thillRobot/mcu-rocket/launch-data/linearacceleration_06_24_2021.png

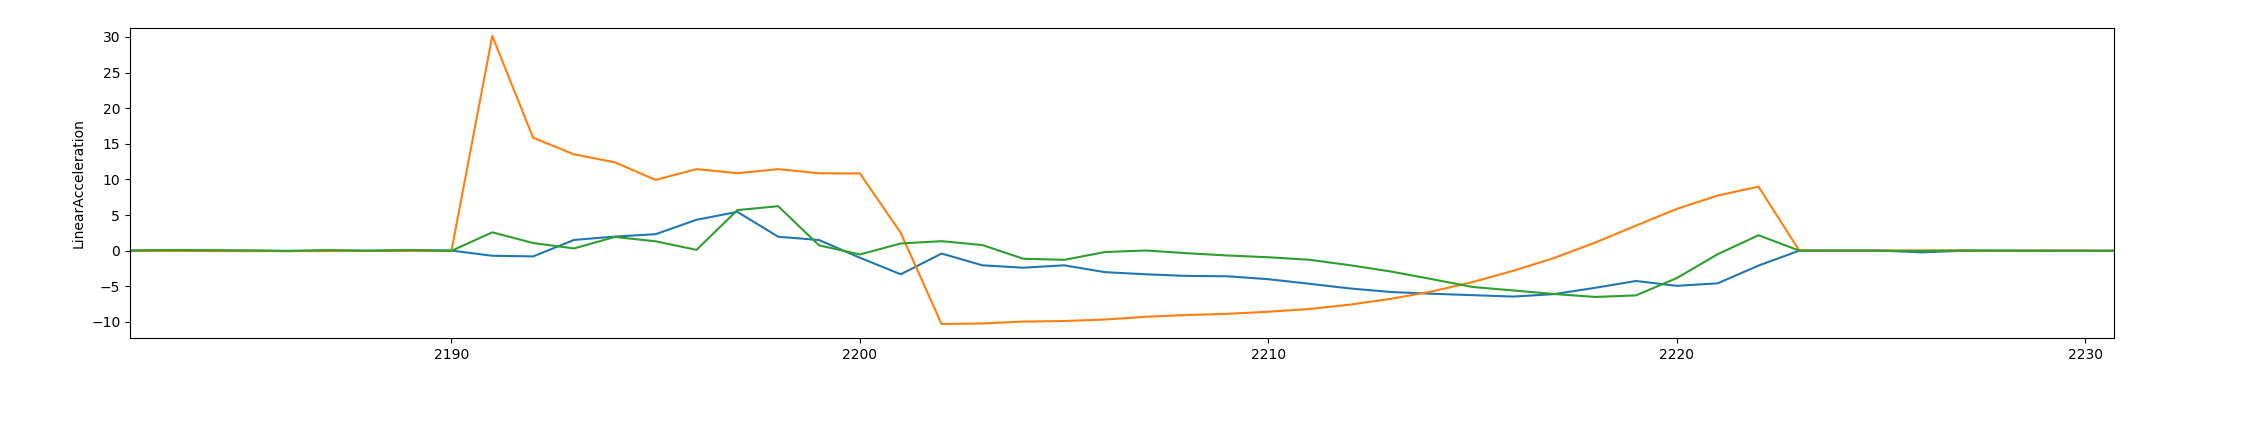
launch-data/linearacceleration_06_24_2021.png
