thillRobot/mcu-rocket/launch-data/NANO-0-06-25-2025-zoomed.png

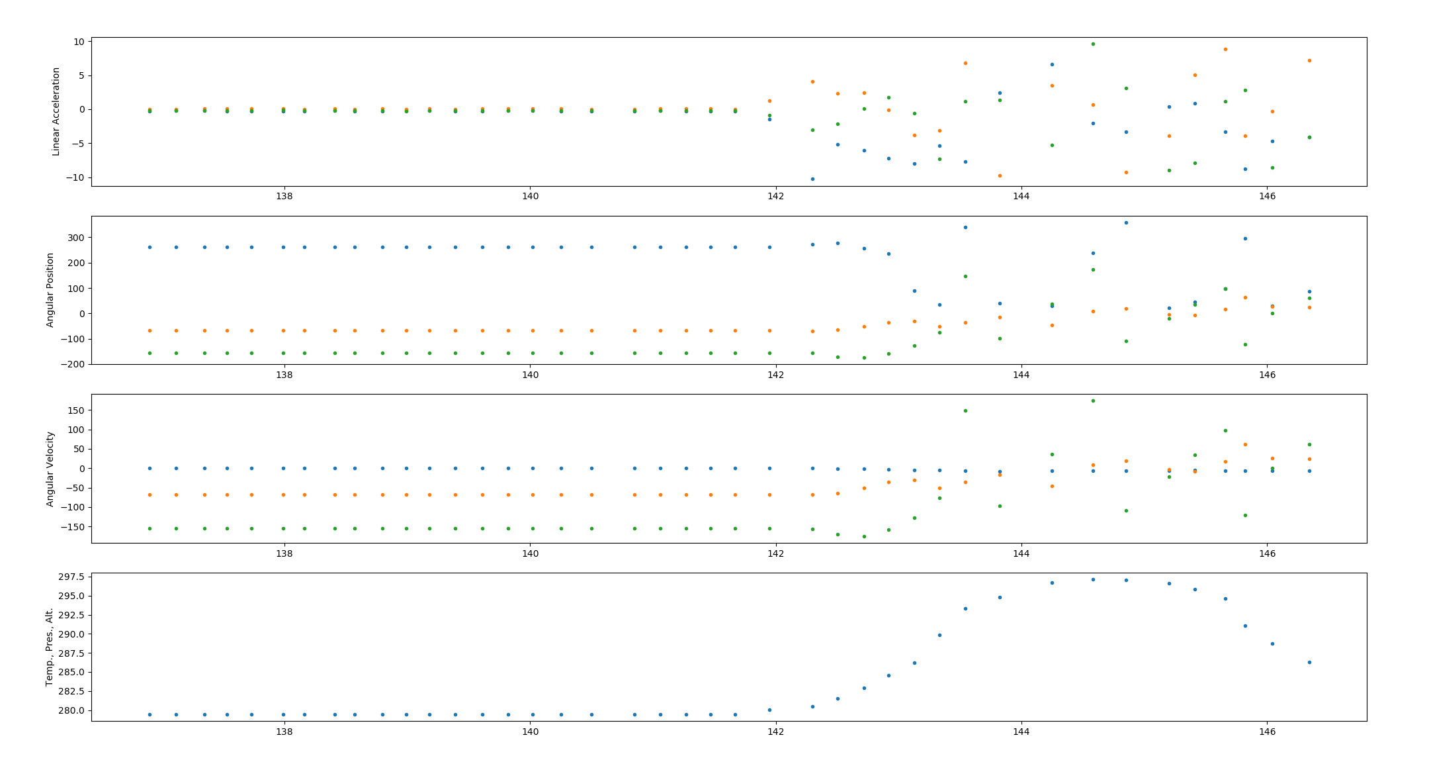
launch-data/NANO-0-06-25-2025-zoomed.png
