thillRobot/mcu-rocket/launch-data/NANO-0-06-25-2025.png

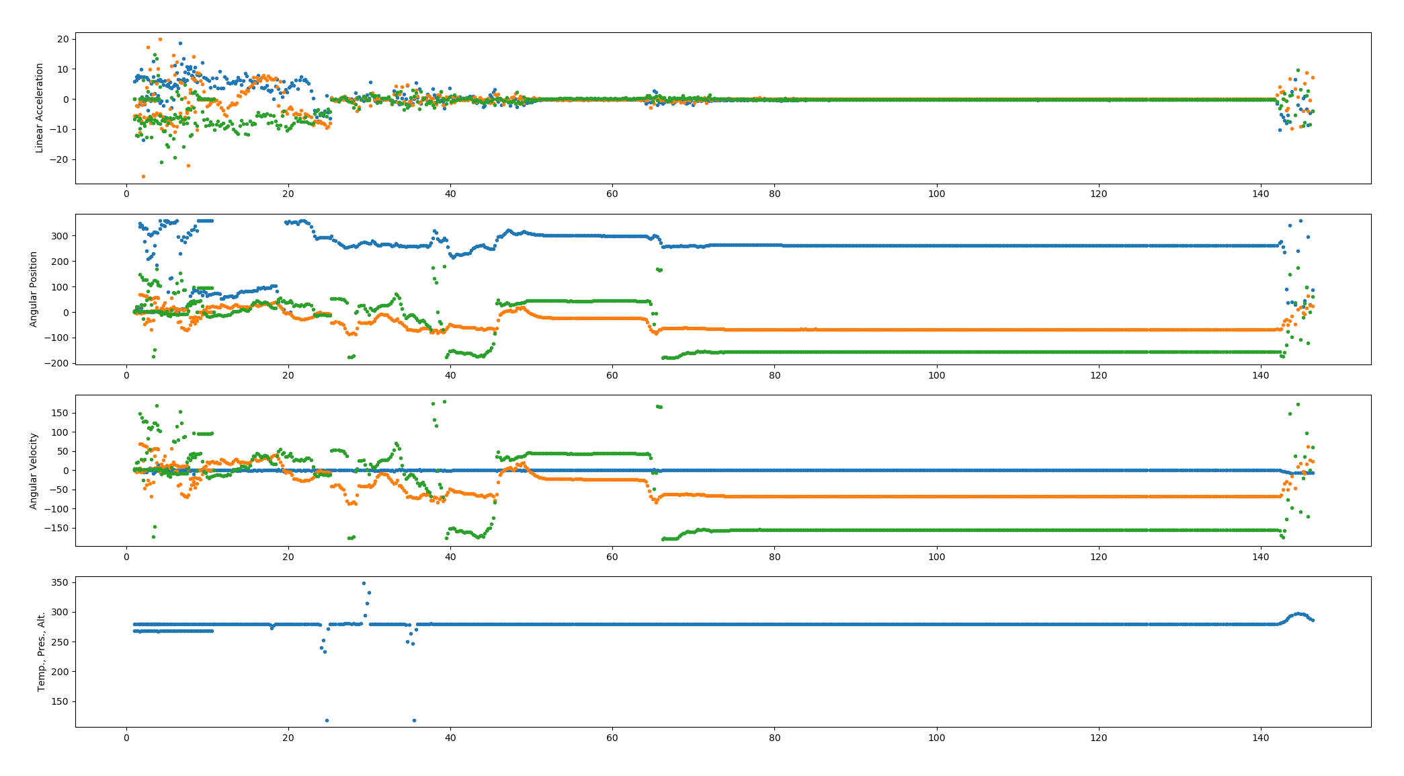
launch-data/NANO-0-06-25-2025.png
