thillRobot/mcu-rocket/launch-data/NANO-1-06-24-2021.png

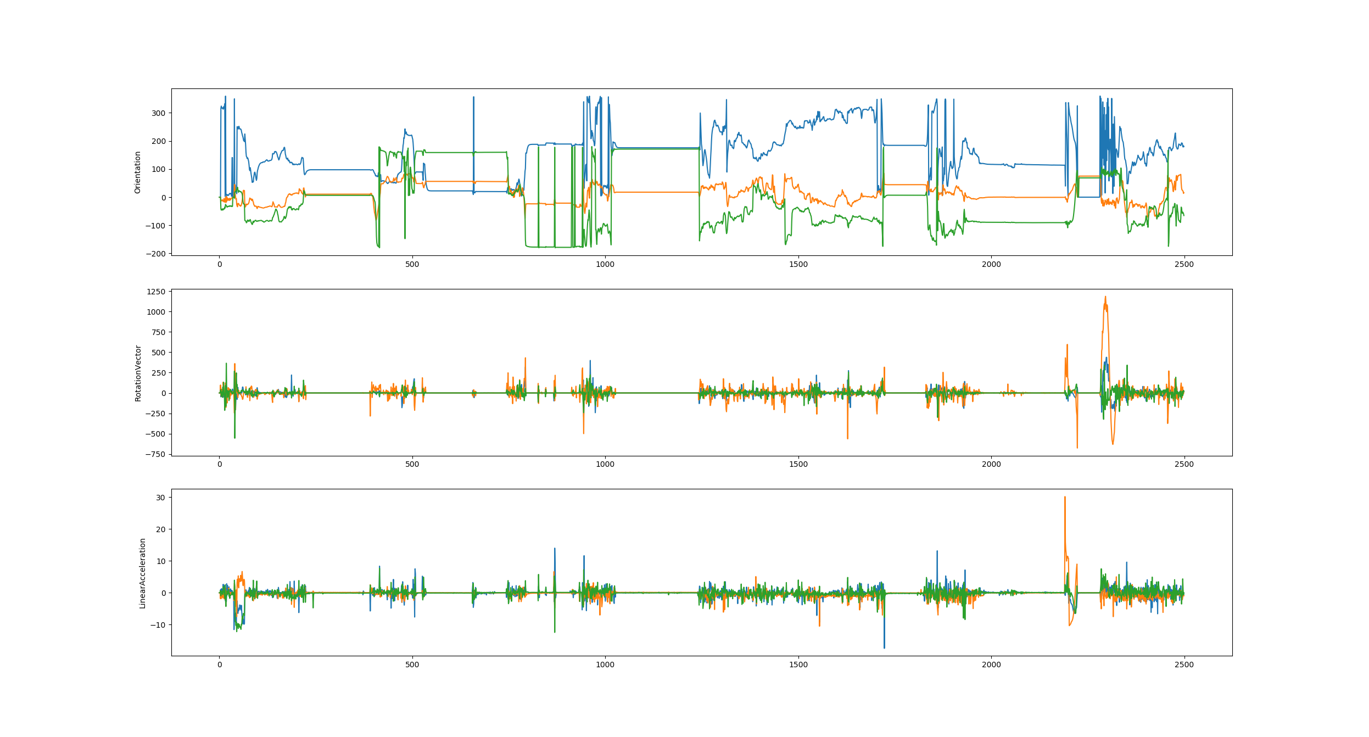
launch-data/NANO-1-06-24-2021.png
