thillRobot/mcu-rocket/launch-data/NANO-1-06-24-2021_cropped_0_250.png

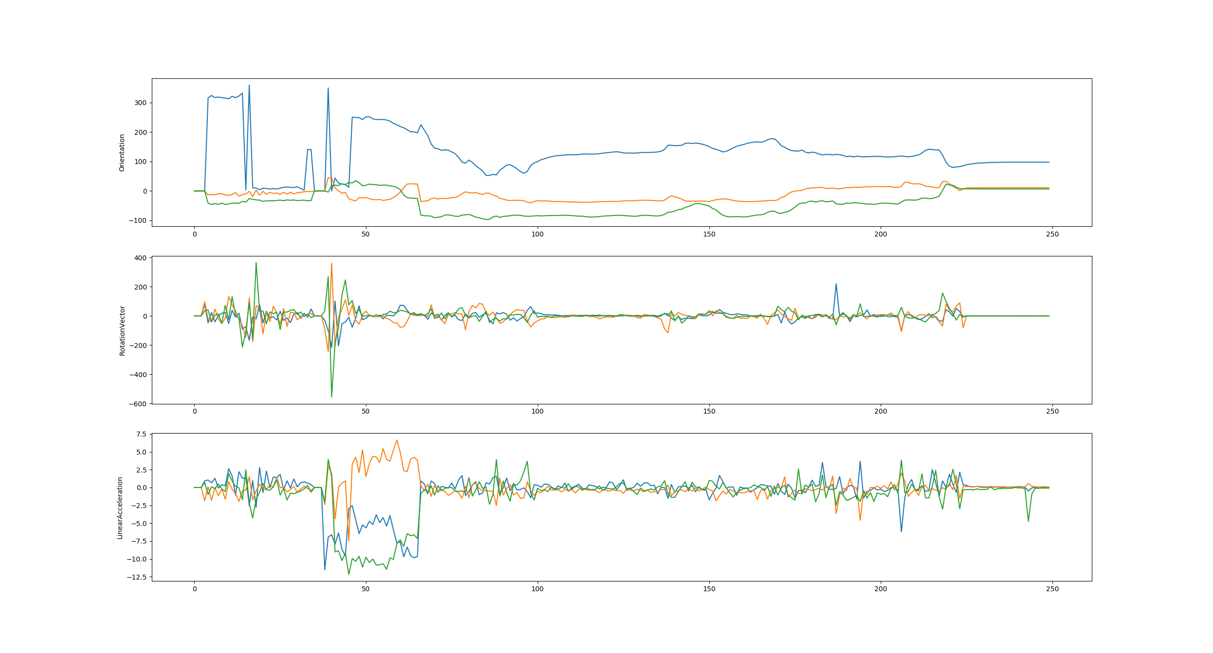
launch-data/NANO-1-06-24-2021_cropped_0_250.png
