thillRobot/mcu-rocket/launch-data/NANO-1-06-24-2021_cropped_2150_2450.png

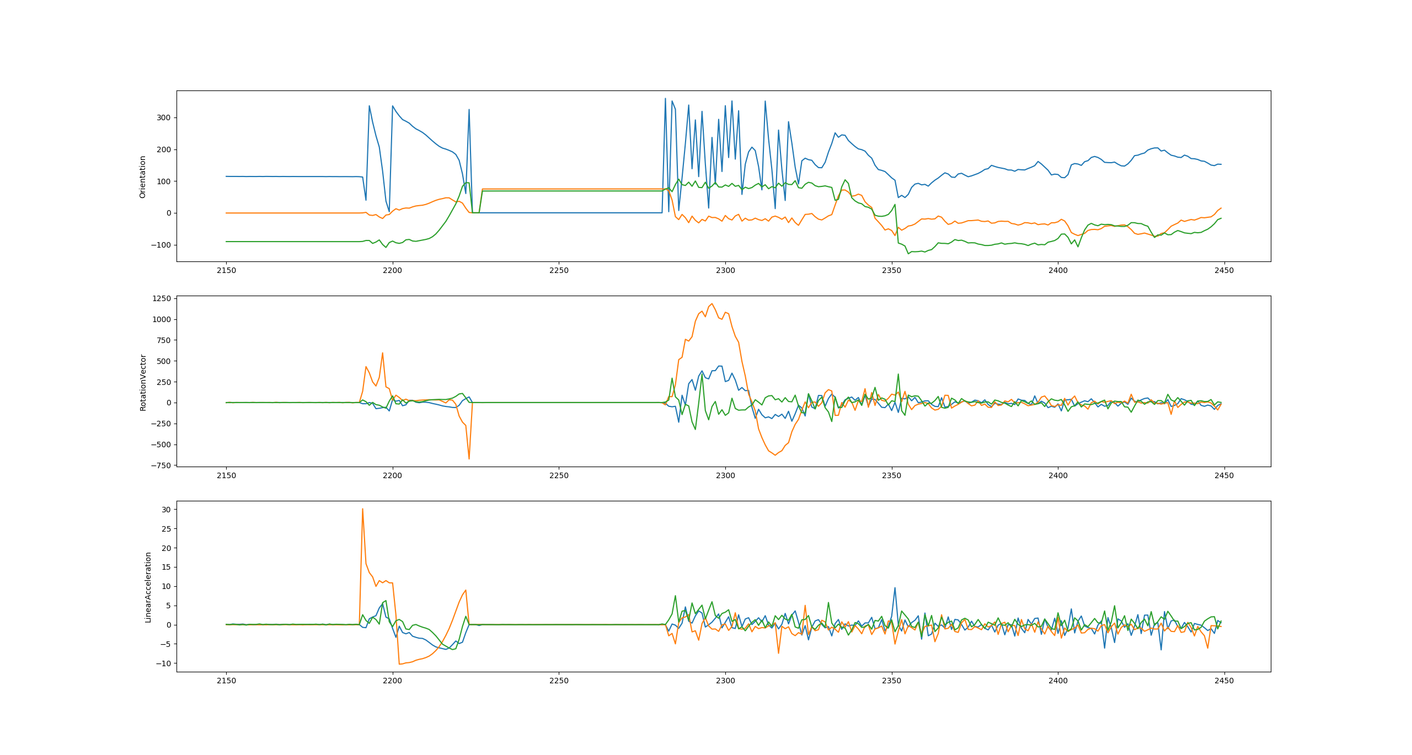
launch-data/NANO-1-06-24-2021_cropped_2150_2450.png
