thillRobot/mcu-rocket/launch-data/NANO-300-06-25-2025.png

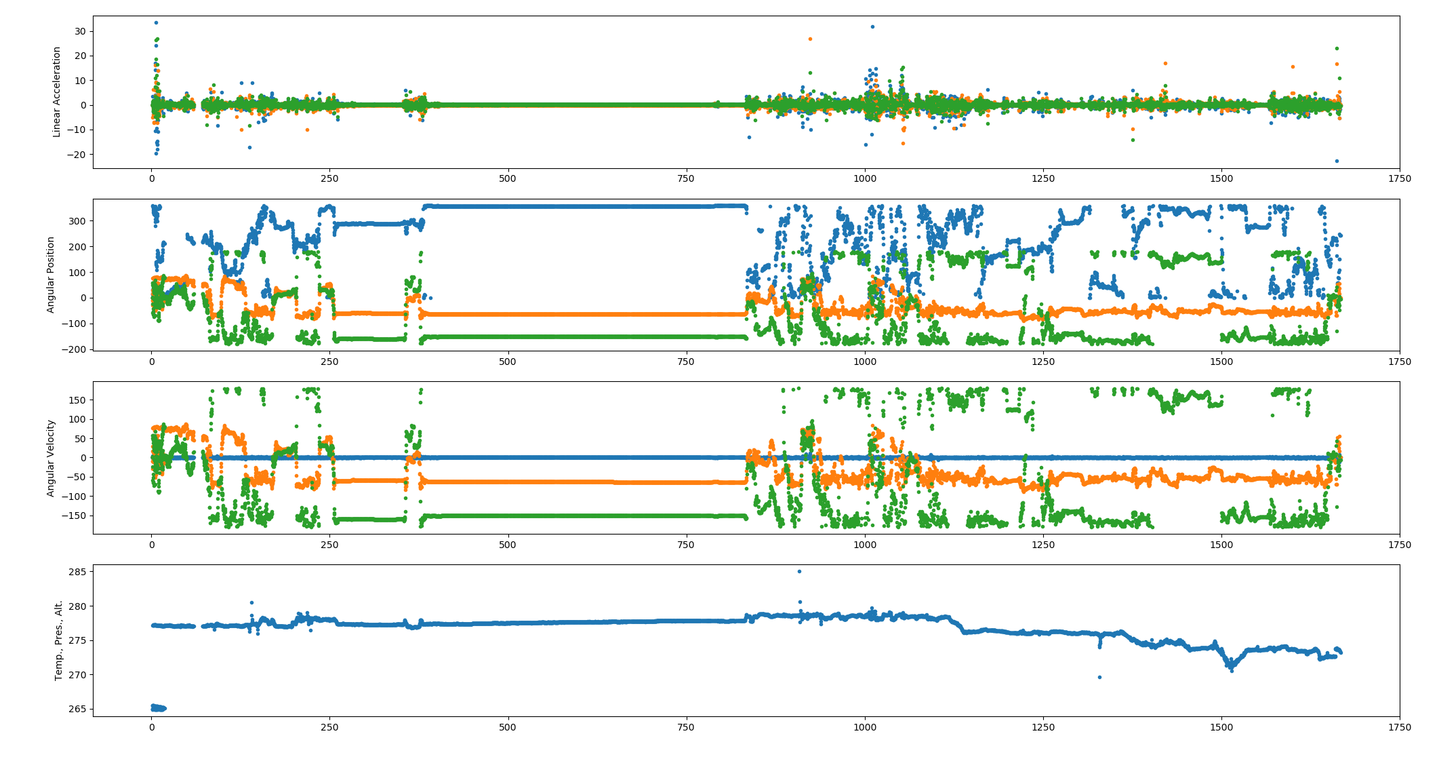
launch-data/NANO-300-06-25-2025.png
