thillRobot/mcu-rocket/pcb-design/kicad/mcu_rocket_nano/mcu_rocket_nano_top.png

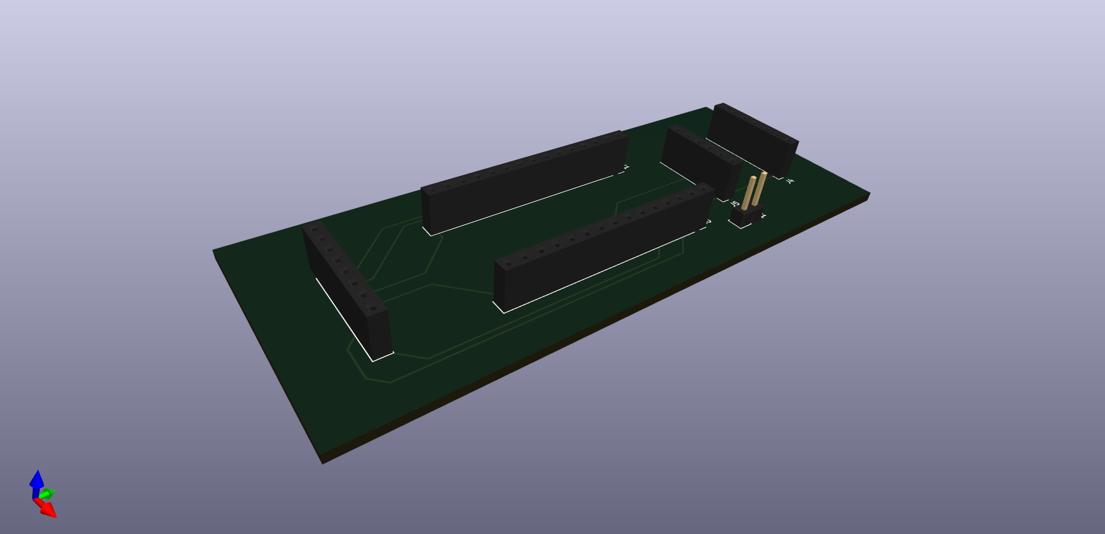
pcb-design/kicad/mcu_rocket_nano/mcu_rocket_nano_top.png
