thillRobot/mcu-rocket/rocket-design/png-images/motor_mount1.png

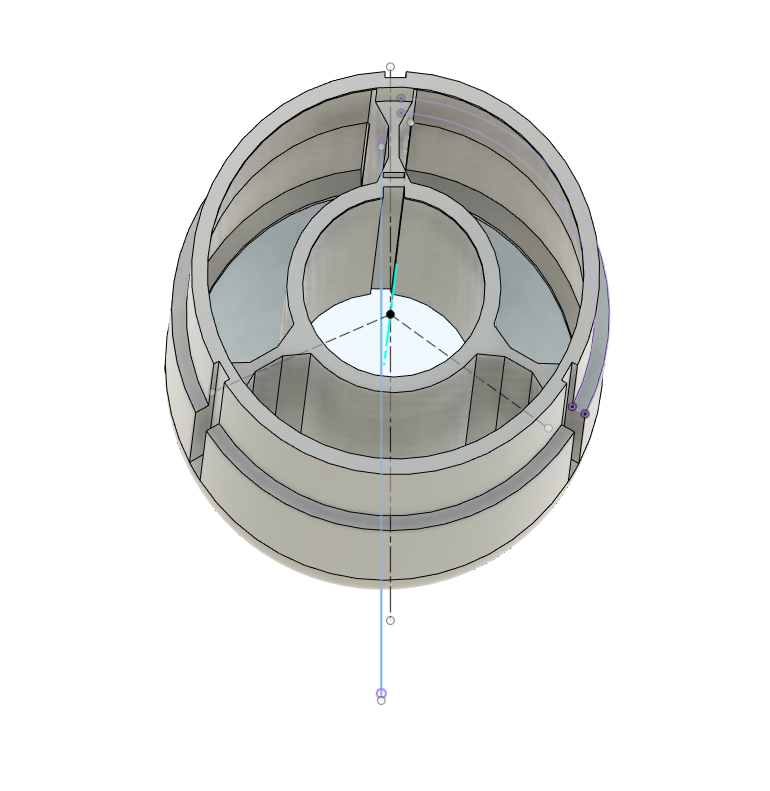
rocket-design/png-images/motor_mount1.png
