thillRobot/mcu-rocket/rocket-design/png-images/science_nosecone2.png

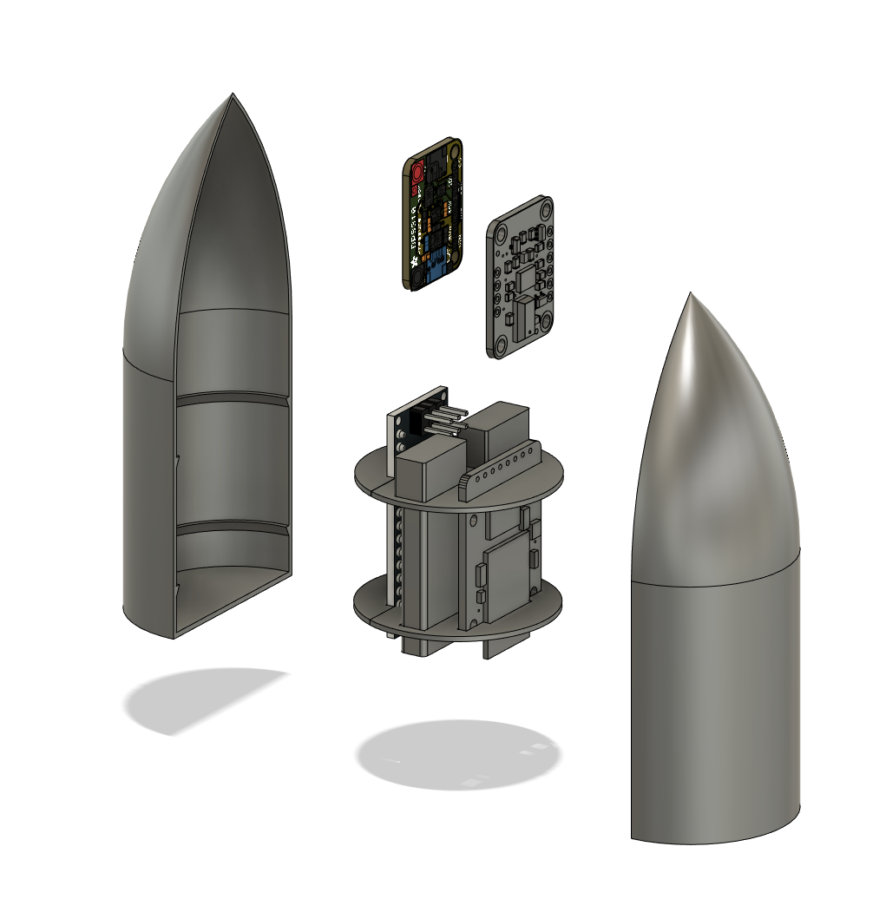
rocket-design/png-images/science_nosecone2.png
