thillRobot/mcu-rocket/rocket-design/png-images/science_nosecone5.png

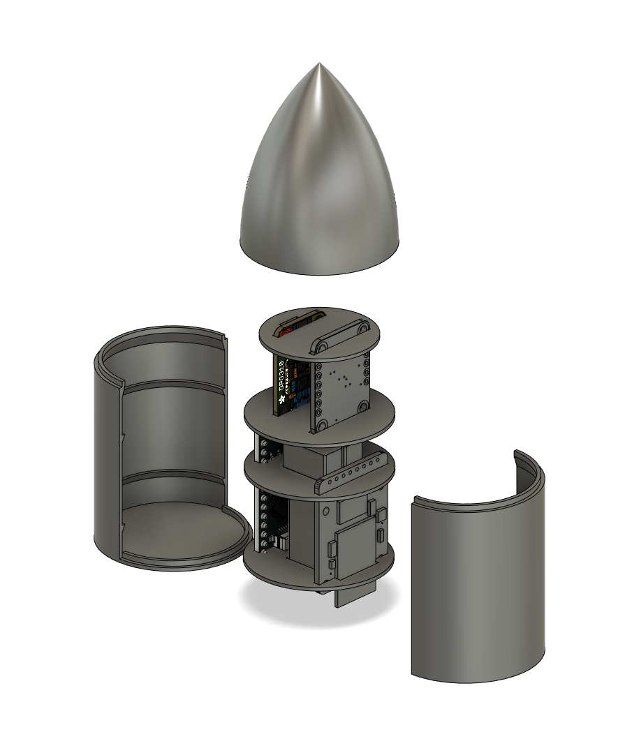
rocket-design/png-images/science_nosecone5.png
