thillRobot/mcu-rocket/rocket-design/png-images/science_nosecone.png

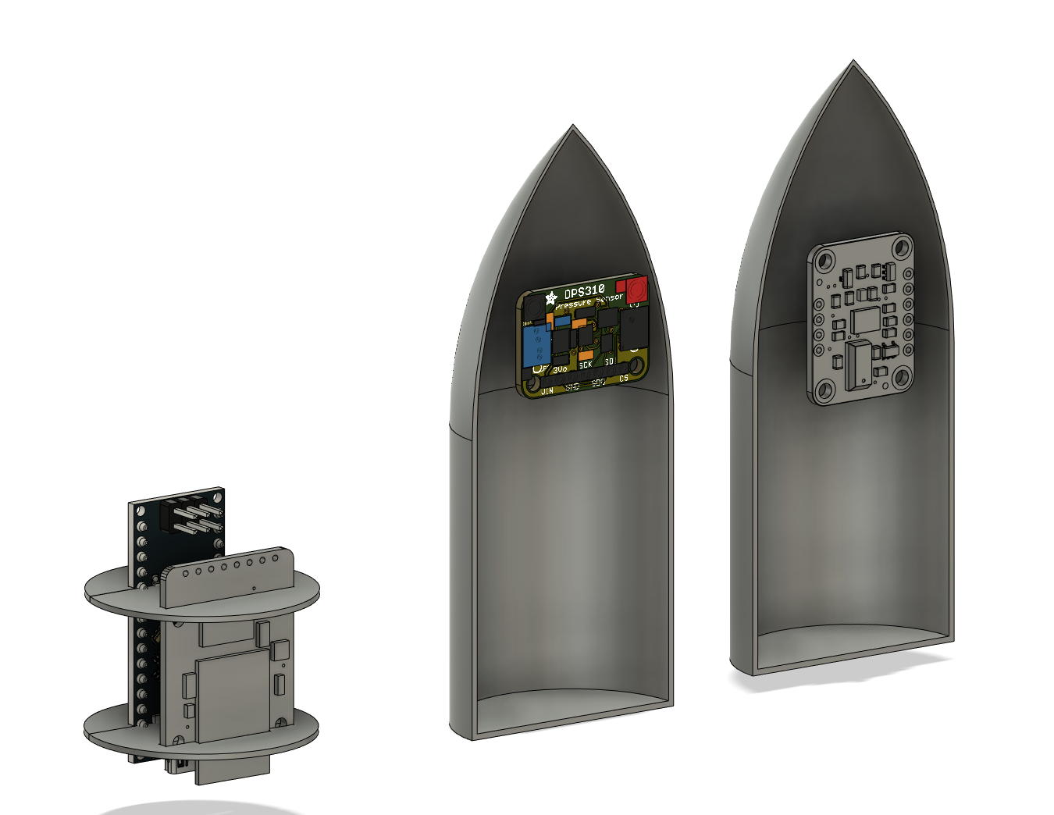
rocket-design/png-images/science_nosecone.png
