thillRobot/mcu-rocket/rocket-design/rocket_design_tables.xlsx

GSET - Summer 2021 - Rocket Design - Tristan Hill
This excel table is used for choosing parameters for the design for a custom model rocket with on-board sensing.
 | Design Variables |  |  |  |  | Material Properties |  |  |  |  | Design Equations
 | Name | Symbol | Unit | Values | Source | Name | Symbol | Unit | Values | Source | Name | Equation
 | distance_nose | dn | mm |  |  | density_petg | rho_petg | g/cm^3 | 1.2-1.3 |  | Equation a - Total Weight | W=wn+wr+wb+we+wf
 | distance_recovery | dr | mm |  |  | density_cardboard | rho_cb |  |  |  | Equation b - Total Area | A=an+ab+af
 | distance_body | db | mm |  |  | density_engine | rho_e |  |  |  | Equation 1 - Center of Gravity | cg*W=dn*wn+dr*wr+db*wb+de*we+df*wf
 | distance_engine | de | mm |  |  | stiffness_petg | E_petg | Mpa | 2950 |  | Equation 2 - Center of Pressure | cp*A=dn*an+db*ab+df*af
 | distance_fins | df | mm |  |  | stiffness_cardboard | E_cb
 |  |  |  |  |  | stiffness_shockcord | E_sc
 | diameter_nose | Dn | mm
 | diameter_body | Db | mm | 38.1,50.8
 | diameter_fins | Df | mm
 |  |  |  |  |  |  |  |  |  |  | Design Requirements
 |  |  |  |  |  |  |  |  |  |  | Name | Requirement
 |  |  |  |  |  |  |  |  |  |  | Requirement 1 - Stabilty Analysis | cg>cp
 |  |  |  |  |  |  |  |  |  |  | Requirement 2 - Reduce Weight | minimize W
 |  |  |  |  |  |  |  |  |  |  | Requirement 3 - Reduce Area | minimize A
 | Dependent Variables
 | Name | Symbol | Unit | Values | Source
 | mass_nose | mn | N
 | mass_recovery | mr | N
 | mass_body | mb | N
 | mass_engine | me | N | 24g | JH
 | mass_fins | mf | N
 | weight_nose | wn | N
 | weight_recovery | wr | N
 | weight_body | wb | N
 | weight_engine | we | N
 | weight_fins | wf | N
 | area_nose | an | mm^2
 | area_body | ab | mm^2
 | area_fins | af | mm^2
 | weight_total | W | N
 | area_total | A | mm^2
 | center_gravity | cg | mm
 | center_pressure | cp | mm
 | Measured Variables
 | 2x24in body tube | l | in | 25+11/16 | TH
 |  | d | in | 2+1/16
 |  | t | in | 0.075
 | c65 engine | m | g | 24.5
 | nosecone(3d porinted) | mv2 | g | 18.5
 |  | mv3 | g | 16.5
 | electronics | nano | g | 3.6
 |  | bno055 | g | 2.3
 |  | dps310 | g | 1.8
 |  | 5vready_sdboard | g | 3.4
 |  | battery(150mA) | g | 4
 |  | header(1x15mlml) | g | 1
 | recovery | parachute | g | 3.9
