thillRobot/mcu-rocket/rocket-design/png-images/rocket_assembly1.png

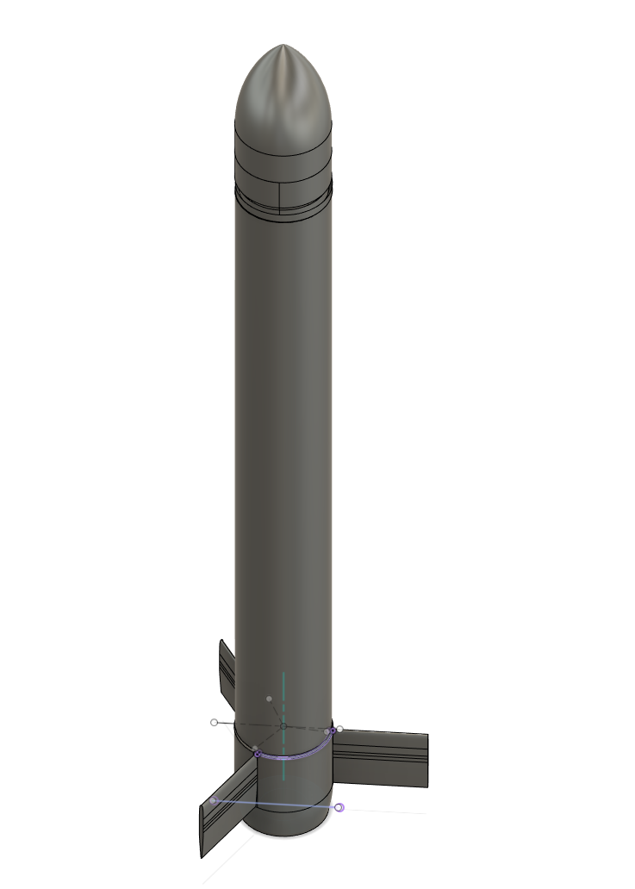
rocket-design/png-images/rocket_assembly1.png
