thillRobot/mcu-rocket/rocket-design/png-images/rocket_assembly2.png

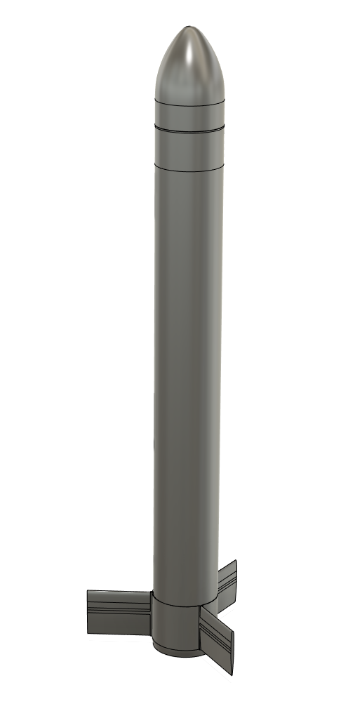
rocket-design/png-images/rocket_assembly2.png
