thillRobot/mcu-rocket/pcb-design/kicad/mcu_rocket_nano/mcu_rocket_nano.kicad_pcb

## KiCad design pcb-design/kicad/mcu_rocket_nano/mcu_rocket_nano.kicad_pcb (2026-05-27)

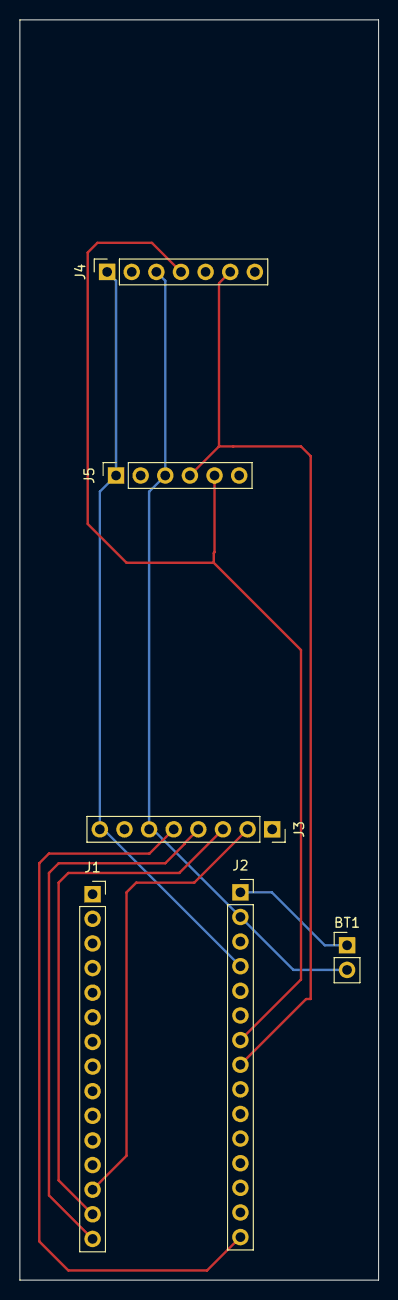
[picture p27: board mcu_rocket_nano.kicad_pcb from above]

Board: 2 copper layers, 37.0 x 130.0 mm, 6 parts (0 on the bottom side), 9 nets.

Parts:
BT1: Battery_Cell; PinHeader_1x02_P2.54mm_Vertical
J1, J2: Conn_01x15_Socket; PinSocket_1x15_P2.54mm_Vertical
J3: SD Reader; PinSocket_1x08_P2.54mm_Vertical
J4: DPS310; PinSocket_1x07_P2.54mm_Vertical
J5: BNO055; PinSocket_1x06_P2.54mm_Vertical

Connections:
+5V: J2.4 (5V), J3.8 (5V), J4.1 (VIN), J5.1 (VIN)
GND: BT1.2 (-), J2.2 (GND), J3.6 (GND), J4.3 (GND), J5.3 (GND)
unnamed: J1.13 (D10), J3.2 (CS)
unnamed: J1.14 (D11), J3.3 (DI)
unnamed: J1.15 (D12), J3.4 (DO)
unnamed: J2.8 (A4), J4.6 (SDI), J5.4 (SDA)
unnamed: J2.7 (A5), J4.4 (SCK), J5.5 (SCL)
unnamed: J2.15 (D13), J3.5 (CLK)
VCC: BT1.1 (+), J2.1 (VIN)
