thillRobot/mcu-rocket/data-logger/dps310_sensortest/dps310_sensortest.ino

// This example gets individual Sensor objects for temperature/pressure!

#include <Adafruit_DPS310.h>

Adafruit_DPS310 dps;
Adafruit_Sensor *dps_temp = dps.getTemperatureSensor();
Adafruit_Sensor *dps_pressure = dps.getPressureSensor();

void setup() {
  Serial.begin(38400);
  while (!Serial) delay(10);

  Serial.println("DPS310");
  if (! dps.begin_I2C(0x77)) {
    Serial.println("Failed to find DPS");
    while (1) yield();
  }
  Serial.println("DPS OK!");

  // Setup highest precision
  dps.configurePressure(DPS310_64HZ, DPS310_64SAMPLES);
  dps.configureTemperature(DPS310_64HZ, DPS310_64SAMPLES);

  dps_temp->printSensorDetails();
  dps_pressure->printSensorDetails();
}

void loop() {
  sensors_event_t temp_event, pressure_event;
  
  if (dps.temperatureAvailable()) {
    dps_temp->getEvent(&temp_event);
    Serial.print(F("Temperature = "));
    Serial.print(temp_event.temperature);
    Serial.println(" *C");
    Serial.println();
  }

  // Reading pressure also reads temp so don't check pressure
  // before temp!
  if (dps.pressureAvailable()) {
    dps_pressure->getEvent(&pressure_event);
    Serial.print(F("Pressure = "));
    Serial.print(pressure_event.pressure);
    Serial.println(" hPa"); 
  
    Serial.println();
  }
}
