thillRobot/mcu-rocket/(commit log)

2021-06-06 fixing READMEs for branches
    [data-logger.ino]
2021-06-25 added launch 06/24/2021 data and python/parse.py
    [pyvenv.cfg]
2021-06-25 added rocket-design with PNG images and rocket_design_tables.xlsx
    [rocket_design_tables.xlsx]
2021-06-28 replaced Strings and c strings
    [data-logger.ino]
2021-06-29 replaced sprintf() with snprintf() to prevent c string overflow
    [data-logger.ino]
2021-07-01 replaced Strings with char arrays
    [data-logger.ino]
2021-07-01 fixed upper case png file extensions
2021-07-01 added interrupt based timestamps to datalog
2021-07-01 changed printData to printSensors
2021-07-01 adding DPS310, i2c error
    [data-logger.ino]
2025-06-27 parsing launch-data gset 2025
    [NANO-0-06-25-2025b.csv, NANO-300-06-25-2025b.csv]
2026-05-27 added kicad files
    [mcu_rocket_nano.csv, mcu_rocket_nano.kicad_pcb, mcu_rocket_nano.kicad_sch]
